SebastianGalo/slowtech_midi_controller/hardware/595_cascade.png

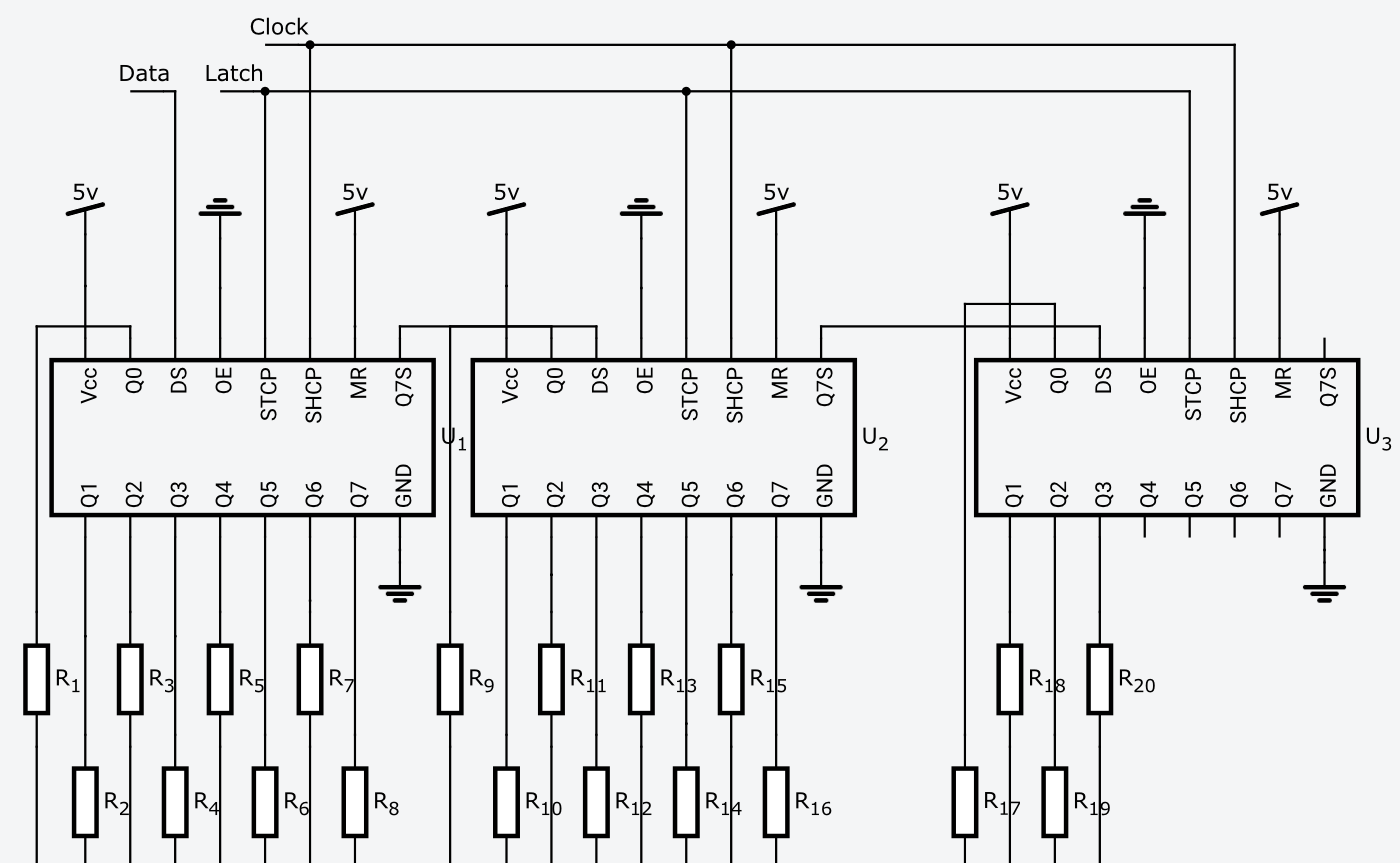
hardware/595_cascade.png
