SebastianGalo/slowtech_midi_controller/hardware/Buttons_leds_diagram.jpg

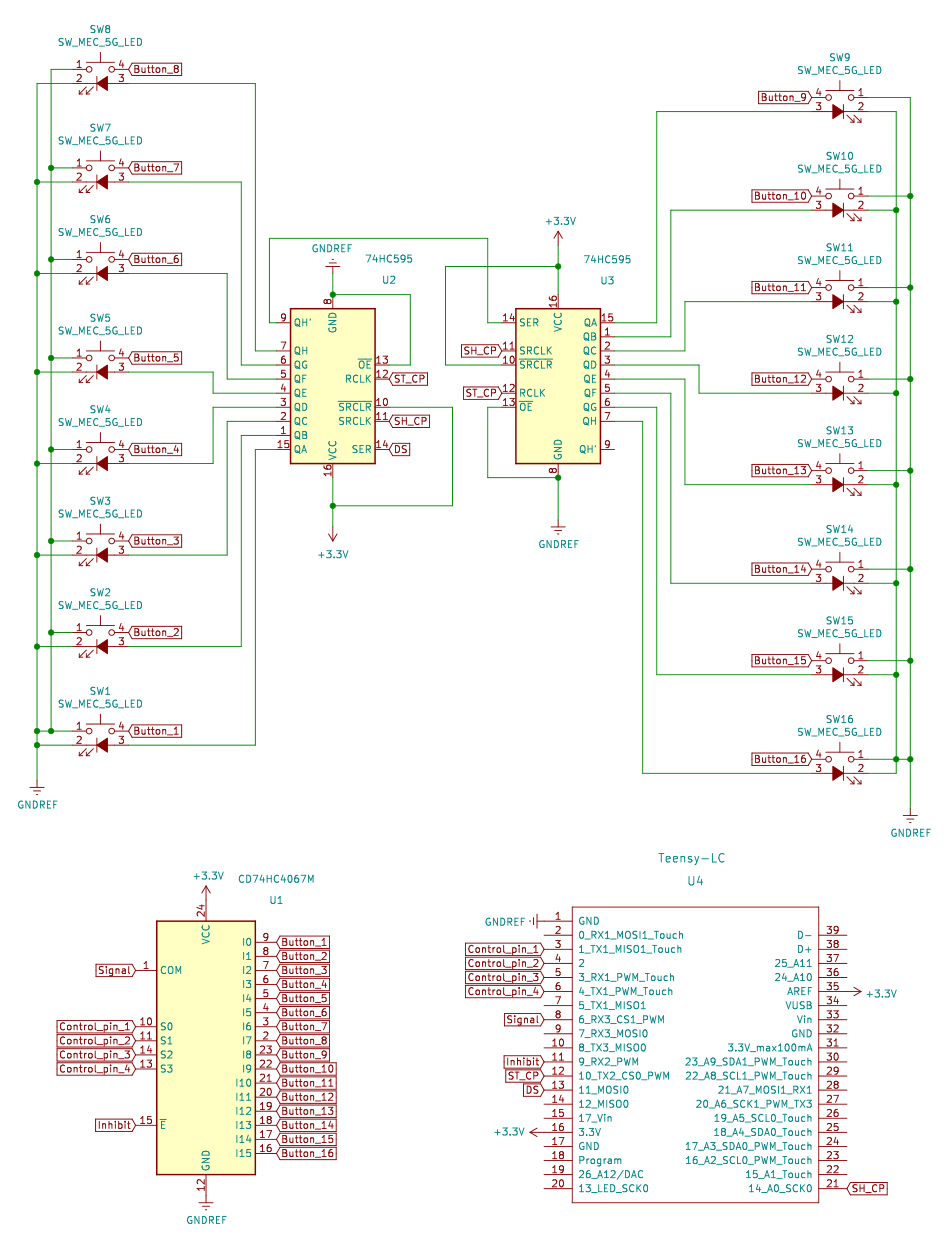
hardware/Buttons_leds_diagram.jpg
