SebastianGalo/slowtech_midi_controller/hardware/cd4067.png

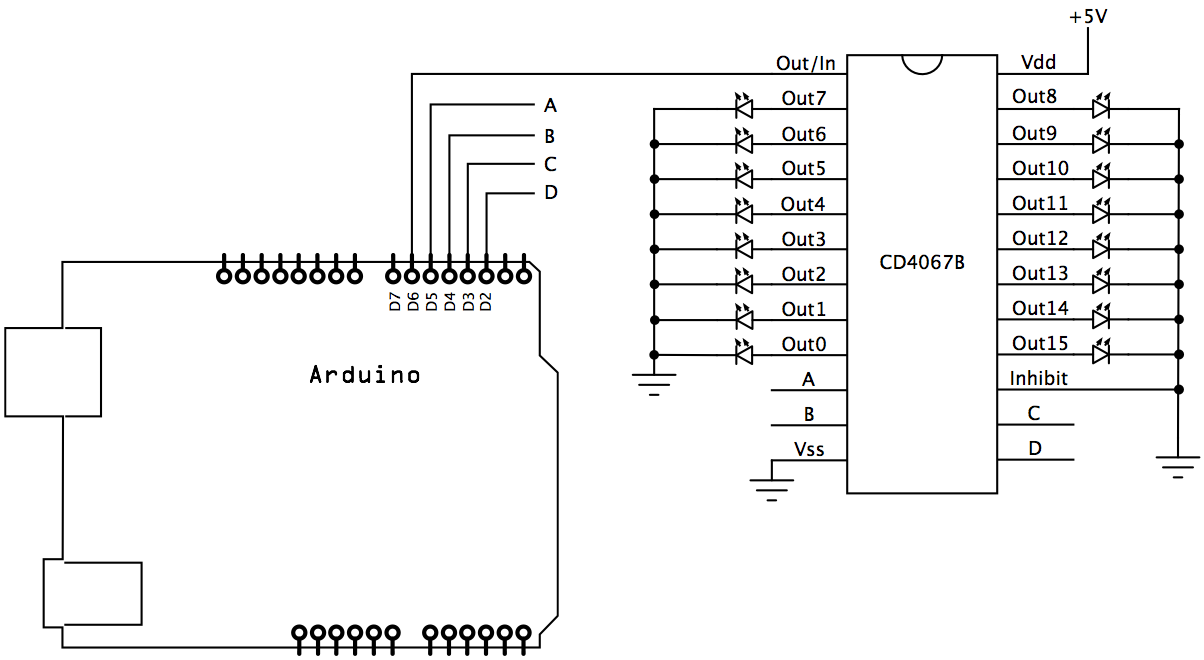
hardware/cd4067.png
