SebastianGalo/slowtech_midi_controller/hardware/designprocess/IMG_3682.JPG

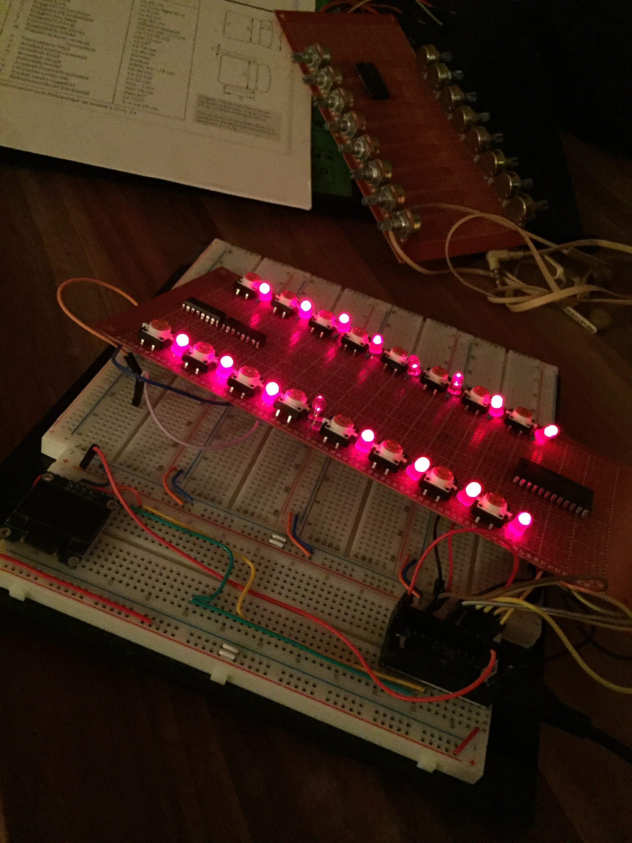
hardware/designprocess/IMG_3682.JPG
