SebastianGalo/slowtech_midi_controller/hardware/designprocess/IMG_3686.JPG

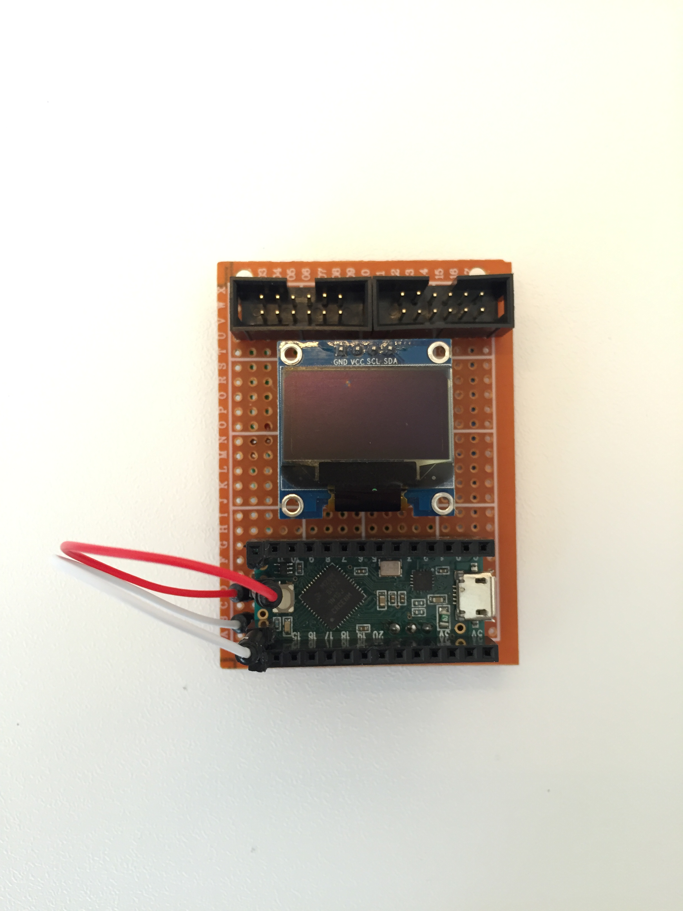
hardware/designprocess/IMG_3686.JPG
