SebastianGalo/slowtech_midi_controller/hardware/Slowtech_complete_3.0.pdf

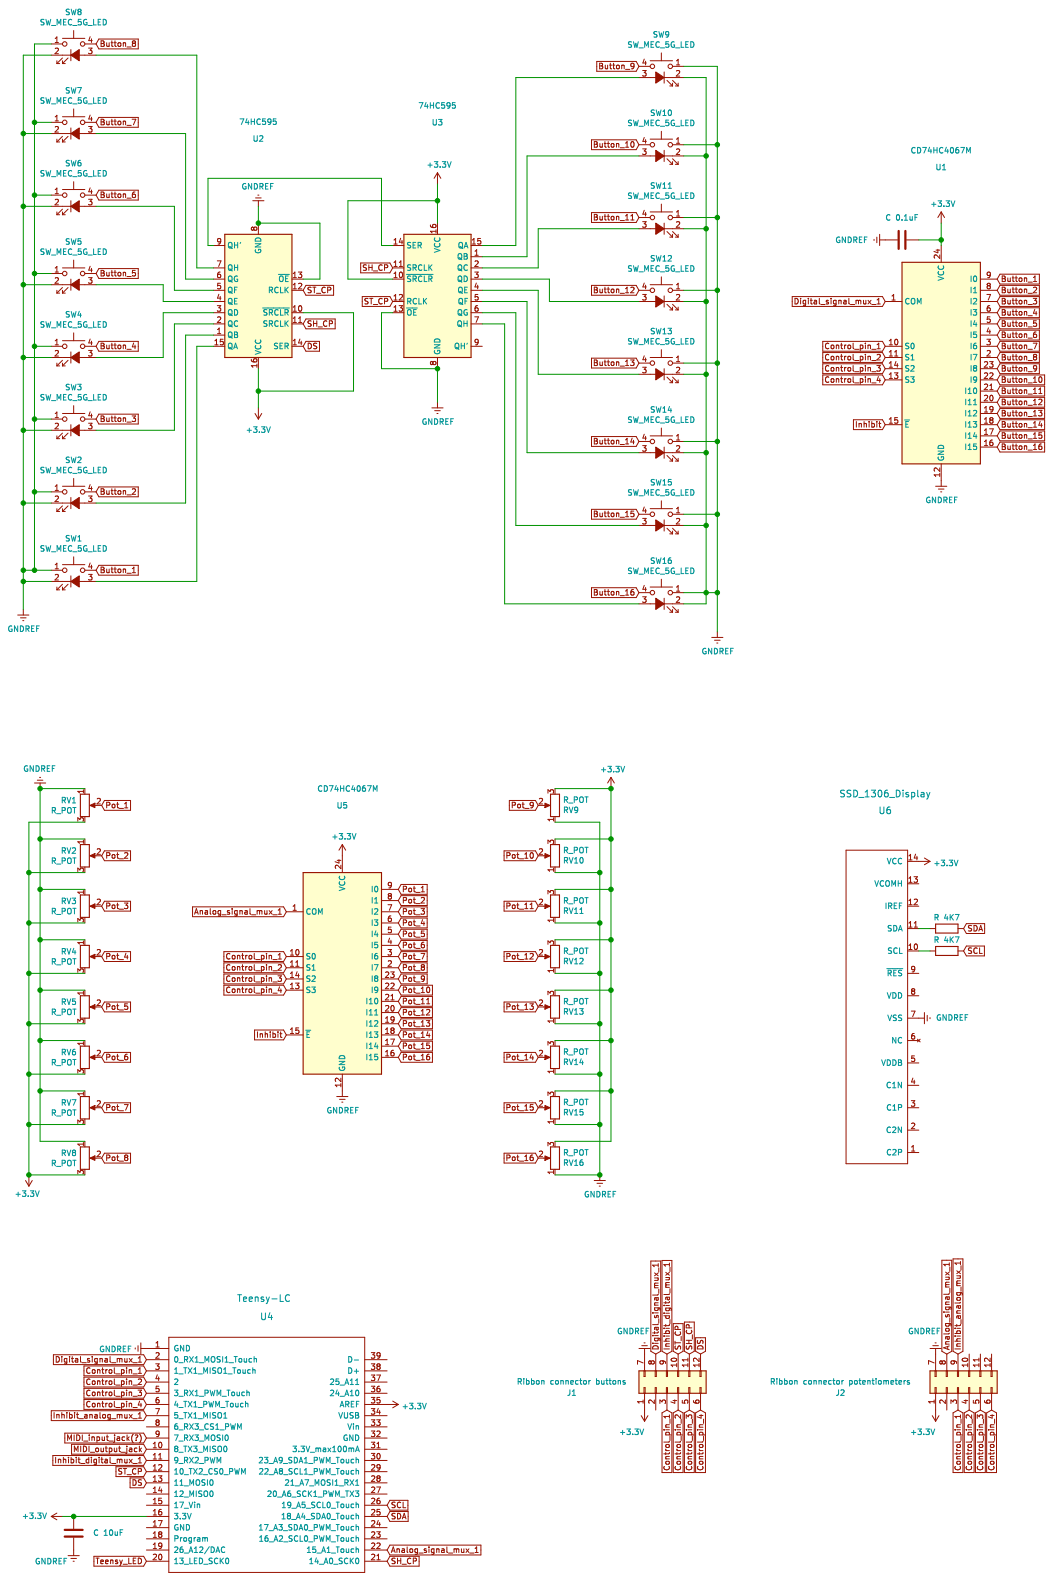
[picture p17: page 1]
