SebastianGalo/slowtech_midi_controller/hardware/Buttons_leds_diagram.pdf

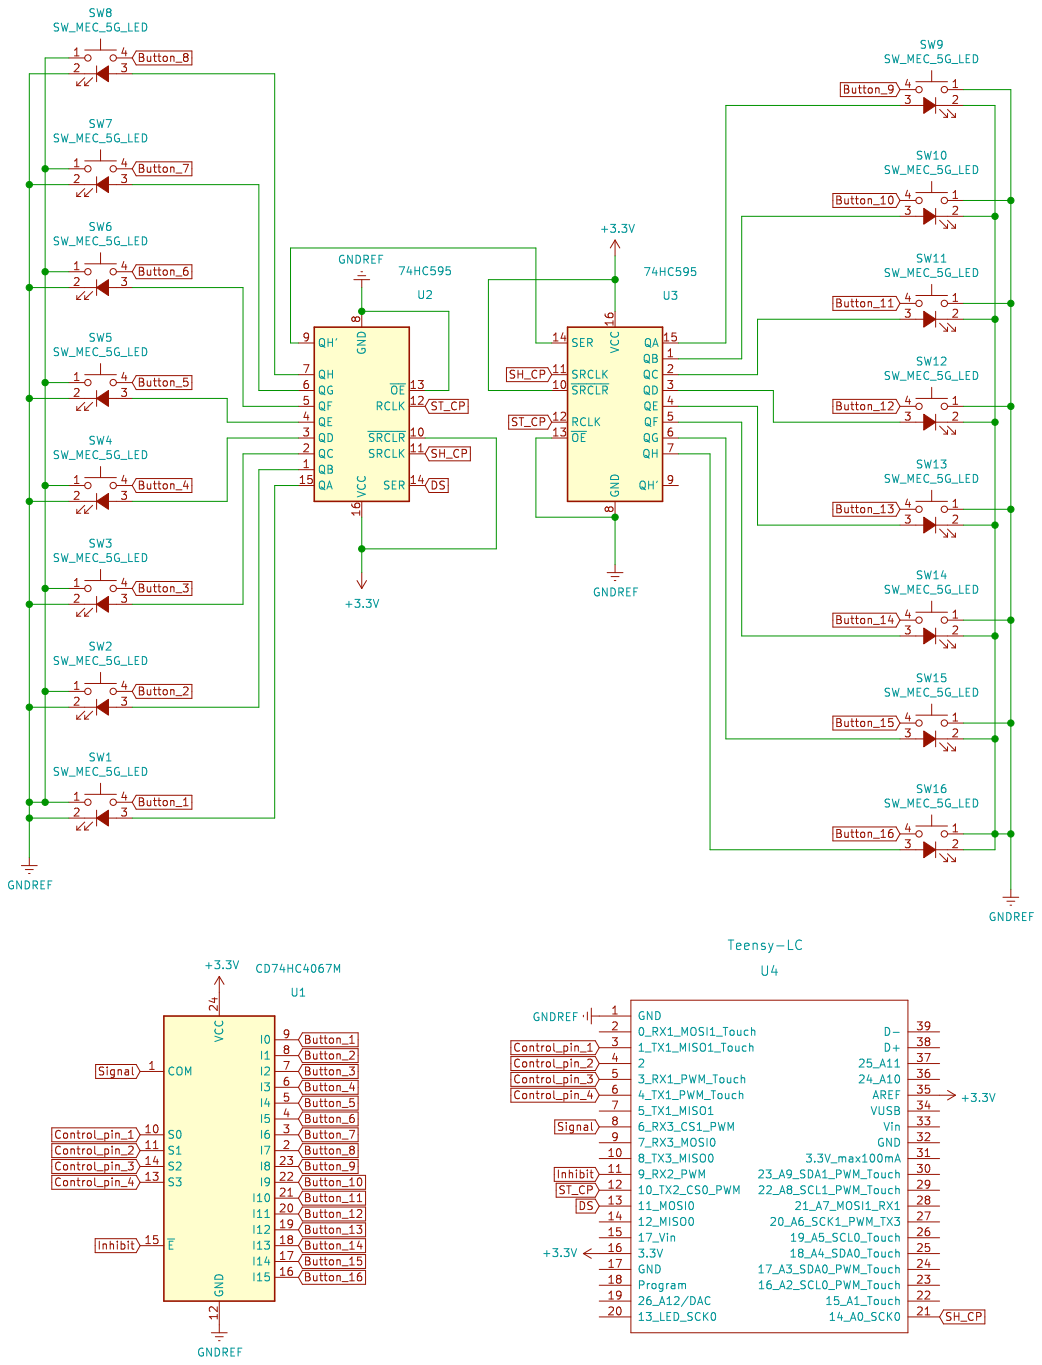
[picture p18: page 1]
