SebastianGalo/slowtech_midi_controller/(commit log)

2018-08-26 Update and rename Teensy_monster_edit_buttons_leds_complete.ino to Teensy_monster_2.0_buttons_leds.ino
2018-08-26 Update and rename Teensy_monster_edit_buttons_leds_simple.ino to Teensy_monster_2.1_buttons_leds_simple.ino
2018-08-26 Update and rename Teensy_monster_edit_potentiometers_working.ino to Teensy_monster_2.1_potentiometers.ino
2018-08-26 Update and rename Teensy_monster_edit_buttons_simple_toggle_release.ino to Teensy_monster_2.1_buttons_simple_toggle_release.ino
2018-08-26 Update and rename Teensy_monster_edit_buttons_simple_working.ino to Teensy_monster_2.1_buttons_simple_working.ino
2018-08-27 Update and rename teensy_monster_2.0.ino to slowtech_2.0.ino
2018-08-27 Update and rename teensy_monster_2.1_buttons.ino to slowtech_2.1_buttons.ino
2018-08-27 Update and rename teensy_monster_2.1_potentiometers.ino to slowtech_2.1_potentiometers.ino
2018-08-27 Update and rename teensy_monster_2.2_buttons_leds.ino to slowtech_2.2_buttons_leds.ino
2018-08-27 Update and rename teensy_monster_2.2_buttons_toggle_release.ino to slowtech_2.2_buttons_toggle_release.ino
2018-08-29 Change name on Teensy, use as tab.
2018-08-29 Working buttons branch, old I/O settings.
2018-08-29 Non-working LED branch, old I/O settings.
2018-08-29 Bugging buttons "send on release" branch, old I/O.
    [slowtech_2.2_buttons_toggle_release.ino]
2018-08-29 LED's working besides some bugs.
    [slowtech_2.3.1.ino]
2018-08-29 LED's working. Bugs in button reading half solved.
    [slowtech_2.3.1.ino]
2019-11-03 Add files via upload
    Needs some revision on the switch-board, routing is wrong and pull-up resistors are missing.
